FirstKlaas/neobee/documentation/source/index.rst

.. NeoBee documentation master file, created by
   sphinx-quickstart on Mon Feb  3 15:21:27 2020.
   You can adapt this file completely to your liking, but it should at least
   contain the root `toctree` directive.



Welcome to NeoBee's documentation!
==================================

.. toctree::
   :maxdepth: 2
   :caption: Contents:

   getting_started
   circuit
   python_environment
   neobee
   entering_command_mode
   calibration
   commands
   f100
   neobeeshell
   mqtt

Indices and tables
==================

* :ref:`genindex`
* :ref:`modindex`
* :ref:`search`
