FirstKlaas/neobee/documentation/source/_static/neobee200.png

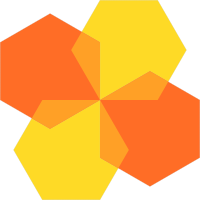
documentation/source/_static/neobee200.png
