FirstKlaas/neobee/documentation/drawings/Circuit.pdf

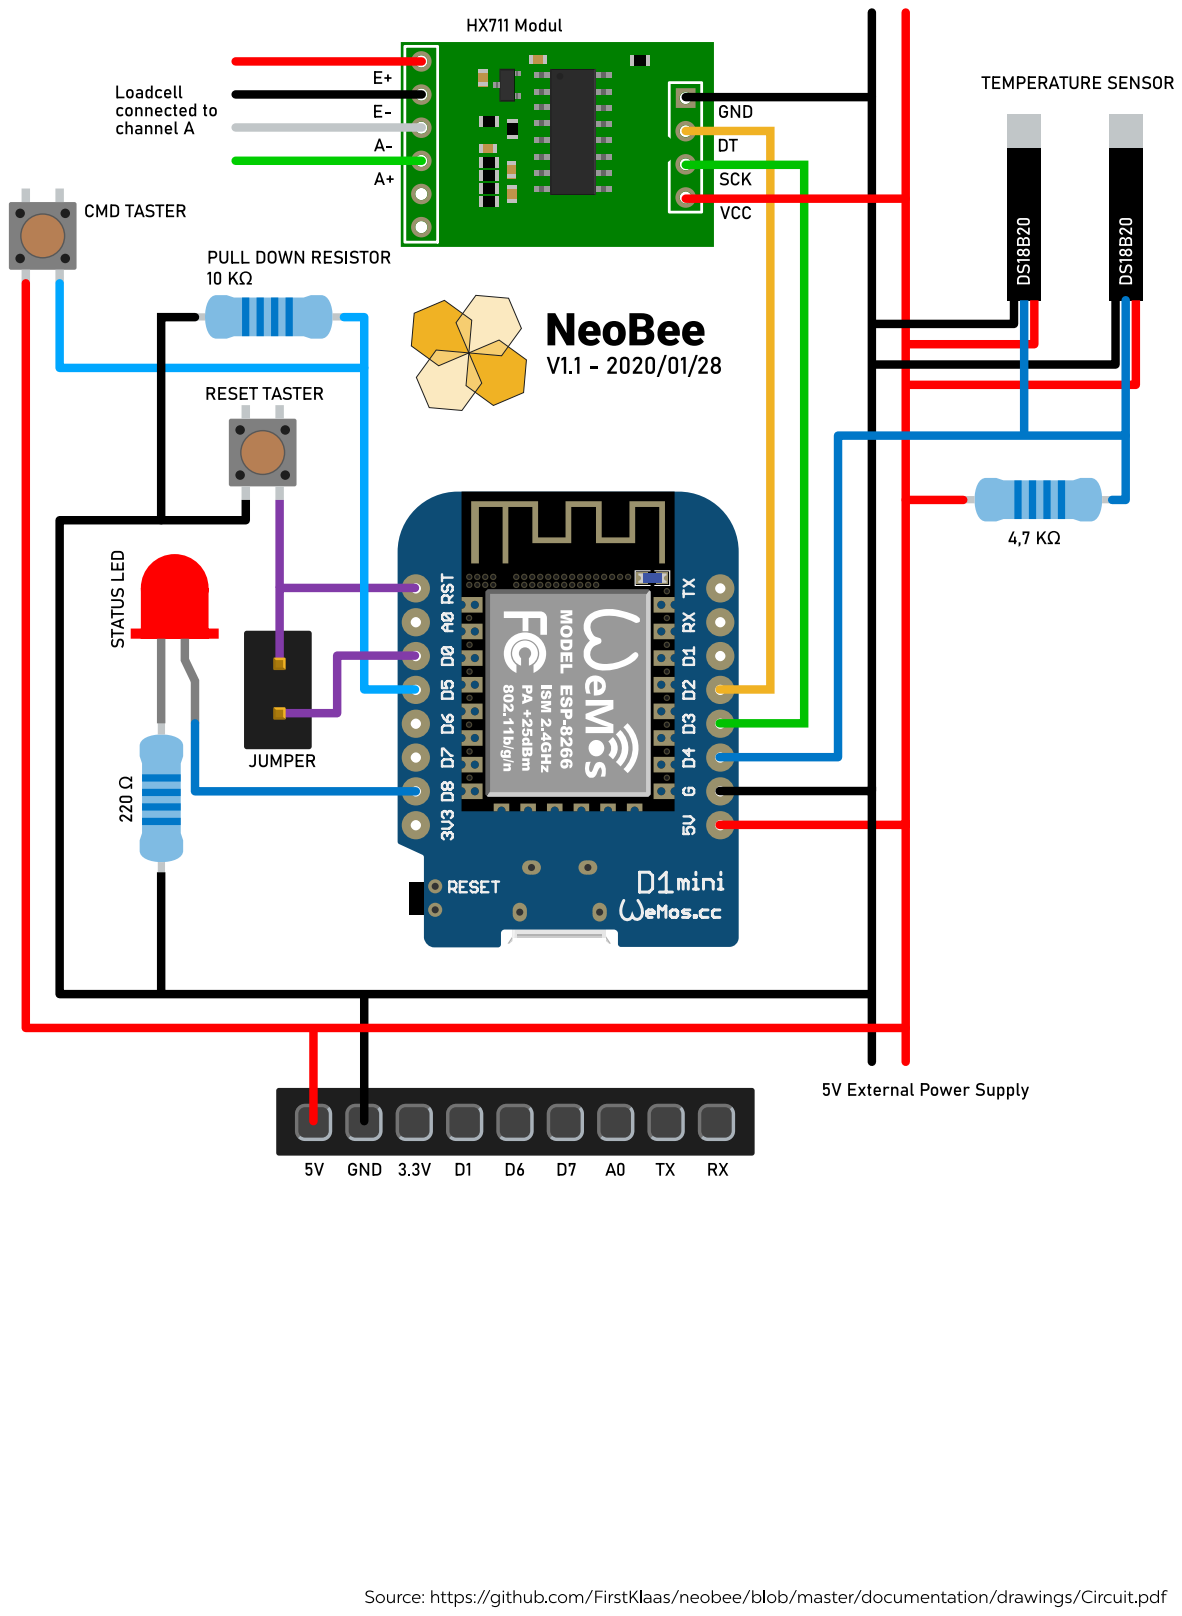
[picture p3: page 1]
