FirstKlaas/neobee/neobee_firmware/src/neobeeMqtt.cpp

#include "neobeeMqtt.h"
#include "neobeeUtil.h"
#include "neobeeVersion.h"

#include <ESP8266WiFi.h>
#include <PubSubClient.h>


WiFiClient espClient;
PubSubClient client(espClient);

#define buffer_size 64 // The buffer size for messages to send
#define NbMqtt m_ctx.mqttServer

NeoBeeMqtt::NeoBeeMqtt(Context& ctx): 
m_buffer(nullptr), m_ctx(ctx) 
{
    memset(m_ctx.mqttServer.host_name,0,30);
    memset(m_ctx.mqttServer.login,0,30);
    memset(m_ctx.mqttServer.password,0,30);
    m_ctx.mqttServer.port = 0;
    client.setCallback([this] (char* topic, byte* payload, unsigned int length) { this->callback(topic, payload, length); }); 
};

NeoBeeMqtt::~NeoBeeMqtt() {
    delete[] m_buffer;
};

void NeoBeeMqtt::setHost(const uint8_t* host) {
    memcpy(m_ctx.mqttServer.host_name, host, 30);
};

void NeoBeeMqtt::printHost(uint8_t* dest) {
    memcpy(dest, m_ctx.mqttServer.host_name, 30);
};

void NeoBeeMqtt::setPort(uint16_t port) {
    m_ctx.mqttServer.port = port;
};

uint16_t NeoBeeMqtt::getPort() {
    return m_ctx.mqttServer.port;
}; 

void NeoBeeMqtt::callback(char* topic, byte* payload, unsigned int length) {

};

bool NeoBeeMqtt::connect(uint8_t number_of_tries) {
    if (isConnected()) return true;

    // Checking the prerequisites to connect to mqtt.
    if (!m_ctx.mqttServer.hostnameSet()) {
        #ifdef DEBUG
        Serial.println("No hostname set.");
        #endif
        return false;
    };

    if (!m_ctx.mqttServer.portSet()) {
        #ifdef DEBUG
        Serial.println("No port set.");
        #endif
        return false;
    };

    uint8_t i = 0;

    String clientId = stringFromByteAray(m_ctx.name, sizeof(m_ctx.name));
    clientId += "-";
    clientId += WiFi.macAddress();

    #ifdef DEBUG
    Serial.println("Connecting to mqtt server");
    Serial.print("Mqtt Client ID: ");
    Serial.println(clientId);
    Serial.print("Server: ");
    Serial.print(NbMqtt.getHostName());
    Serial.print(":");
    Serial.println(NbMqtt.port);
    #endif

    String tmpHostName = NbMqtt.getHostName();
    String tmpLogin = NbMqtt.getLogin();
    String tmpPassword = NbMqtt.getPassword();

    client.setServer(tmpHostName.c_str(), NbMqtt.port);
    
    //client.setServer("192.168.178.77", 1883);
    #ifdef DEBUG
    if (!NbMqtt.loginSet()) Serial.print("No Login. ");
    if (!NbMqtt.passwordSet()) Serial.print("No Password.");
    Serial.println();
    
    if (NbMqtt.credentialsSet()) {
        Serial.println("Connecting to mqtt server with credentials.");
    } else {
        Serial.println("Connecting to mqtt server without credentials.");
    };
    #endif

    while (!client.connected() && i < number_of_tries) {
        i++;
        #ifdef DEBUG
        Serial.print(".");
        #endif
        // If credentials are set, use those.
        if (NbMqtt.credentialsSet()) {
            client.connect(
                clientId.c_str(), 
                tmpLogin.c_str(), 
                tmpPassword.c_str(),
                "/neobee/hive/disconnect",
                0, /* Last will QoS */
                0, /* Last will retain */
                WiFi.macAddress().c_str());
        } else {
            client.connect(
                clientId.c_str(),
                "/neobee/hive/disconnect",
                0, /* Last will QoS */
                0, /* Last will retain */
                WiFi.macAddress().c_str());
        };
    };
    #ifdef DEBUG
    Serial.println("");
    #endif

    if (client.connected()) {
        uint8_t* bufferPtr(getBuffer());
        uint32_t ip = uint32_t(WiFi.localIP());
        
        // Clearing out the buffer
        memset(bufferPtr,0,bufferSize());
        // Storing the MAC address in the first six bytes
        WiFi.macAddress(bufferPtr);
        bufferPtr += 6;
        memcpy(bufferPtr, &ip, 4);
        bufferPtr += 4;

        // First Test to write the firmware version
        // Storing the IP in the next four bytes
        bufferPtr[0] = MAJOR_VERSION;
        bufferPtr[1] = MINOR_VERSION;
        bufferPtr[2] = BUILD_VERSION;
        bufferPtr += 3;

        // Storing the name in the next 20 bytes
        printByteArray(m_ctx.name, 20);
        memcpy(bufferPtr, m_ctx.name, 20);
        bufferPtr += 20;
        #ifdef DEBUG
        Serial.println("Connected. Publishing connect message.");
        #endif
        client.publish("/neobee/hive/connect", getBuffer(), bufferPtr - getBuffer(), false);

    } else {
        #ifdef DEBUG
        Serial.println("Could not connect to mqtt server");
        Serial.print(NbMqtt.getHostName());
        Serial.print(":");
        Serial.println(NbMqtt.port);
        
        #endif
    };
    
    return client.connected();
}

bool NeoBeeMqtt::isConnected() 
{
    return client.connected();
};

uint8_t* NeoBeeMqtt::getBuffer() {
    if (m_buffer == nullptr) {
        m_buffer = new uint8_t[bufferSize()];
    };
    return m_buffer;
};

uint8_t NeoBeeMqtt::operator[](const uint8_t index) {
    if (index >= buffer_size) {
        return 0;
    };
    uint8_t* buffer = getBuffer();
    return buffer[index];
};

size_t NeoBeeMqtt::bufferSize() const {
    return buffer_size;
};

void NeoBeeMqtt::publishData(float weight, float tempInside, float tempOutside) {
    uint8_t* bufferPtr(getBuffer());

    if (connect()) {
        WiFi.macAddress(bufferPtr);
        bufferPtr += 6;
        writeFloat100(weight, bufferPtr);
        bufferPtr += 4;
        writeFloat100(tempInside, bufferPtr);
        bufferPtr += 4;
        writeFloat100(tempOutside, bufferPtr);
        bufferPtr += 4;
        client.publish("/neobee/hive/rawdata", getBuffer(), 18);
        #ifdef DEBUG
        Serial.println("mqtt publish: /neobee/hive/rawdata");
        printByteArray(getBuffer(), 18);
        Serial.print("Weight              : ");
        Serial.println(weight);
        Serial.print("Temperature Inside  : ");
        Serial.println(tempInside);
        Serial.print("Temperature Outside : ");
        Serial.println(tempOutside);
        
        #endif
        memset(getBuffer(),0,18);
    }
}

void NeoBeeMqtt::loop() {
    if (connect()) client.loop();
}
