FirstKlaas/neobee/neobee_firmware/src/neobeeUtil.cpp

#include "neobeeUtil.h"

#include <Arduino.h>

void writeUInt32(uint32_t value, uint8_t* dst) {
  dst[0] = (value >> 24) & 0xff;
  dst[1] = (value >> 16) & 0xff;
  dst[2] = (value >> 8) & 0xff;
  dst[3] = value & 0xff;
}

void writeInt32(int32_t value, uint8_t* dst) {
  boolean NEGFLAG(value < 0);

  // If value is negative, write the
  // positive value and set the negative
  // flag
  if (NEGFLAG) {
    value *= -1;
  } 
  dst[0] = (value >> 24) & 0xff;
  dst[1] = (value >> 16) & 0xff;
  dst[2] = (value >> 8) & 0xff;
  dst[3] = value & 0xff;
  // If the original value was negative, 
  // set the highest bit to one to 
  // indicate a negative value.
  if (NEGFLAG) {
    dst[0] |= 0b10000000;
  }
}

double readDouble100(uint8_t* dst) {
  return (double) (readInt32(dst) / 100.0);
}

float readFloat100(uint8_t* dst) {
  return (float) (readInt32(dst) / 100.0f);
}

int32_t readInt32(uint8_t* dst)
{
  bool NEG_FLAG(dst[0] >> 7);
  int32_t value(0);

  value = (dst[0] & 0b01111111) << 24;
  value |= dst[1] << 16;
  value |= dst[2] << 8;
  value |= dst[3];

  return (double) (NEG_FLAG ? value * -1 : value);
}

inline uint32_t readUInt32(uint8_t* dst)
{
  return (dst[0] << 24) + (dst[1] << 16) + (dst[2] << 8) + (dst[3]); 
}

String stringFromByteAray(const uint8_t* src, const uint8_t size) {
  String dest = String();
  for (uint8_t i=0; i< size; i++) {
    if (src[i] == 0) break;
    dest += char(src[i]);
  };
  return dest;
}

String toHex8String(uint8_t *data, uint8_t size)
{
    // Create a buffer for storing the hex characters plus one 
    char tmp[(size << 1) + 1];
    for (byte i=0; i<size; i++) {
            sprintf(tmp+(i<<1), "%.2X",data[i]);
    }
    tmp[size<<1] = '\0';
    return String(tmp);
}

void writeFloat100(float val, uint8_t* dest) {
  writeInt32(int(val * 100.f + 0.5f), dest);
}  

void writeDouble100(double val, uint8_t* dest) {
  writeInt32(int(val * 100. + 0.5), dest);
}  
