FirstKlaas/neobee/(commit log)

2020-01-20 Switching to PLatform IO
2020-01-21 Minor bug in switch statement
    [neobeeCmd.cpp]
2020-01-22 commands handled directly in switch statement.
2020-01-22 Serial.print wrapped in #ifdef DEBUG
2020-01-22 implemented tare and calibrate
2020-01-23 Fixed som smaller issues. Name is now byte array.
    [neobeeCmd.cpp, neobeeTypes.h]
2020-01-23 memcmp and WifiNetwork - Fixed change from char* to uint8_t* in name. - Added a WifiNetwork data structure
    [neobeeTypes.h]
2020-01-23 Fixed a bug in setName method.
    [neobeeTypes.h]
2020-01-27 Essential changes. Loading and saving of the configuration works now. Wrong board settings in platformio.ini Stable AP mode now. (Switching from STA to AP)
    [neobeeCmd.cpp, neobeeContext.h, neobeeMqtt.h, neobeeScale.h, neobeeTemperature.h, neobeeTypes.h, neobeeUtil.cpp]
2020-01-27 Some things (LED and Button)
2020-01-27 Circuit Drawing added
2020-01-28 Circuit V1.0 png
2020-01-29 Buffer Size and wrong collor in circuit
    [neobeeMqtt.cpp, neobeeMqtt.h]
2020-01-29 Temperature Command added.
2020-01-29 Check for begin() in temperature
2020-01-29 Switched to readMedAvg in GET_TEMPERATURE
2020-02-02 Major changes. - setting mqtt values works - reset esp command - main loop changed
    [neobeeCmd.cpp, neobeeContext.h, neobeeMqtt.cpp, neobeeMqtt.h, neobeeTypes.h, neobeeUtil.cpp]
2020-02-06 Started to rework commands to respect methods
    [neobeeCmd.cpp, neobeeCmd.h, neobeeContext.h, neobeeScale.cpp, neobeeTypes.h]
2020-02-09 Bug fixed. Wrong line deleted.
    [neobee_firmware.cpp]
2020-02-09 couple of minor things - tare otion in neobee - callibrate option in neobee - count option in neobee - some more documentation
2020-02-10 Fixed a critical firmware bug in calibrate
    [neobeeCmd.cpp, neobeeScale.cpp]
2020-02-17 Wrapped prints in ifdef DEBUG
2021-02-27 Version 0.1.2 of the firmware
    Memory allocation bug fix.
    More debug messages.
    Handeling situation where sensors are absent.
    [generate_header_file.py, neoBeeTemperature.cpp, neobeeMqtt.cpp, neobeeScale.cpp, neobeeScale.h]
2021-02-28 Switched to sphinxcontrib.yt
2021-03-11 Many bugfixes and improvements
    [neoBeeTemperature.cpp, neobeeMqtt.cpp, neobeeMqtt.h, neobeeTemperature.h, neobeeUtil.cpp]
2021-03-11 Updated Build chain. Must be called from the IO CLI. make realease, and you are happy
2021-03-11 Some Bugfixes. Offset can have negativ values. And writing four byte values now treats negative values correctly.
    [neobeeCmd.cpp, neobeeScale.cpp, neobeeTypes.h, neobee_firmware.cpp]
2021-03-13 Request Temperature By Index
2021-03-18 Added a simple debug dumper The pum module just prints out the infos th the console
2021-03-29 Wifi does not work after while. So autoReconnect is enabled. Testing.
    [setupWifi.cpp]
